kazukiminemura/block_illumination/docs/README.md

# 現行構成の概要

Pico 2 H ×1、XD3914 ×3、OSX10201-GYR1 ×3の3チャンネル構成です。

[概要図](overview.svg) → [実端子付き配線図](../hardware/schematic.svg) → [設計・組立・校正手順](../hardware/README.md) の順に参照してください。

Rev CはLTspiceの近似モデルで検証済み、実機検証は未実施です。

概要図再生成：`node docs/build-overview.cjs`。
