kazukiminemura/block_illumination/hardware/connections.csv

reference | physical_pin | function_or_value | net
PICO | 3 | GND | GND
J_PWR | 1 | external regulated 5V +/-5% | 5V
J_PWR | 2 | GND | GND
PICO | 1 | GP0 PWM 20kHz | PWM_CPU
RF_CPU | 1 | 4.7k 1% | PWM_CPU
RF_CPU | 2 | 4.7k 1% | SIG_CPU
RPD_CPU | 1 | 10k | PWM_CPU
RPD_CPU | 2 | 10k | GND
CF_CPU | 1 | 4.7uF X7R >=10V | SIG_CPU
CF_CPU | 2 | 4.7uF X7R >=10V | GND
U_CPU | 2 | GND | GND
U_CPU | 3 | V+ | 5V
U_CPU | 4 | RLO | GND
U_CPU | 5 | SIG | SIG_CPU
U_CPU | 6 | RHI | REF_CPU
U_CPU | 7 | REF_OUT | REF_CPU
U_CPU | 8 | REF_ADJ | GND
U_CPU | 9 | MODE_BAR | 5V
RSET_CPU | 1 | 3.3k 1% | REF_CPU
RSET_CPU | 2 | 3.3k 1% | GND
U_CPU | 1 | OUT1 | K_CPU_1
LED_CPU | 1 | A anode | 5V
LED_CPU | 20 | A cathode | K_CPU_1
U_CPU | 18 | OUT2 | K_CPU_2
LED_CPU | 2 | B anode | 5V
LED_CPU | 19 | B cathode | K_CPU_2
U_CPU | 17 | OUT3 | K_CPU_3
LED_CPU | 3 | C anode | 5V
LED_CPU | 18 | C cathode | K_CPU_3
U_CPU | 16 | OUT4 | K_CPU_4
LED_CPU | 4 | D anode | 5V
LED_CPU | 17 | D cathode | K_CPU_4
U_CPU | 15 | OUT5 | K_CPU_5
LED_CPU | 5 | E anode | 5V
LED_CPU | 16 | E cathode | K_CPU_5
U_CPU | 14 | OUT6 | K_CPU_6
LED_CPU | 6 | F anode | 5V
LED_CPU | 15 | F cathode | K_CPU_6
U_CPU | 13 | OUT7 | K_CPU_7
LED_CPU | 7 | G anode | 5V
LED_CPU | 14 | G cathode | K_CPU_7
U_CPU | 12 | OUT8 | K_CPU_8
LED_CPU | 8 | H anode | 5V
LED_CPU | 13 | H cathode | K_CPU_8
U_CPU | 11 | OUT9 | K_CPU_9
LED_CPU | 9 | I anode | 5V
LED_CPU | 12 | I cathode | K_CPU_9
U_CPU | 10 | OUT10 | K_CPU_10
LED_CPU | 10 | J anode | 5V
LED_CPU | 11 | J cathode | K_CPU_10
CD_CPU | 1 | 100nF X7R >=10V | 5V
CD_CPU | 2 | 100nF X7R >=10V | GND
CB_CPU | 1 | 10uF >=10V | 5V
CB_CPU | 2 | 10uF >=10V | GND
PICO | 4 | GP2 PWM 20kHz | PWM_GPU
RF_GPU | 1 | 4.7k 1% | PWM_GPU
RF_GPU | 2 | 4.7k 1% | SIG_GPU
RPD_GPU | 1 | 10k | PWM_GPU
RPD_GPU | 2 | 10k | GND
CF_GPU | 1 | 4.7uF X7R >=10V | SIG_GPU
CF_GPU | 2 | 4.7uF X7R >=10V | GND
U_GPU | 2 | GND | GND
U_GPU | 3 | V+ | 5V
U_GPU | 4 | RLO | GND
U_GPU | 5 | SIG | SIG_GPU
U_GPU | 6 | RHI | REF_GPU
U_GPU | 7 | REF_OUT | REF_GPU
U_GPU | 8 | REF_ADJ | GND
U_GPU | 9 | MODE_BAR | 5V
RSET_GPU | 1 | 3.3k 1% | REF_GPU
RSET_GPU | 2 | 3.3k 1% | GND
U_GPU | 1 | OUT1 | K_GPU_1
LED_GPU | 1 | A anode | 5V
LED_GPU | 20 | A cathode | K_GPU_1
U_GPU | 18 | OUT2 | K_GPU_2
LED_GPU | 2 | B anode | 5V
LED_GPU | 19 | B cathode | K_GPU_2
U_GPU | 17 | OUT3 | K_GPU_3
LED_GPU | 3 | C anode | 5V
LED_GPU | 18 | C cathode | K_GPU_3
U_GPU | 16 | OUT4 | K_GPU_4
LED_GPU | 4 | D anode | 5V
LED_GPU | 17 | D cathode | K_GPU_4
U_GPU | 15 | OUT5 | K_GPU_5
LED_GPU | 5 | E anode | 5V
LED_GPU | 16 | E cathode | K_GPU_5
U_GPU | 14 | OUT6 | K_GPU_6
LED_GPU | 6 | F anode | 5V
LED_GPU | 15 | F cathode | K_GPU_6
U_GPU | 13 | OUT7 | K_GPU_7
LED_GPU | 7 | G anode | 5V
LED_GPU | 14 | G cathode | K_GPU_7
U_GPU | 12 | OUT8 | K_GPU_8
LED_GPU | 8 | H anode | 5V
LED_GPU | 13 | H cathode | K_GPU_8
U_GPU | 11 | OUT9 | K_GPU_9
LED_GPU | 9 | I anode | 5V
LED_GPU | 12 | I cathode | K_GPU_9
U_GPU | 10 | OUT10 | K_GPU_10
LED_GPU | 10 | J anode | 5V
LED_GPU | 11 | J cathode | K_GPU_10
CD_GPU | 1 | 100nF X7R >=10V | 5V
CD_GPU | 2 | 100nF X7R >=10V | GND
CB_GPU | 1 | 10uF >=10V | 5V
CB_GPU | 2 | 10uF >=10V | GND
PICO | 6 | GP4 PWM 20kHz | PWM_NPU
RF_NPU | 1 | 4.7k 1% | PWM_NPU
RF_NPU | 2 | 4.7k 1% | SIG_NPU
RPD_NPU | 1 | 10k | PWM_NPU
RPD_NPU | 2 | 10k | GND
CF_NPU | 1 | 4.7uF X7R >=10V | SIG_NPU
CF_NPU | 2 | 4.7uF X7R >=10V | GND
U_NPU | 2 | GND | GND
U_NPU | 3 | V+ | 5V
U_NPU | 4 | RLO | GND
U_NPU | 5 | SIG | SIG_NPU
U_NPU | 6 | RHI | REF_NPU
U_NPU | 7 | REF_OUT | REF_NPU
U_NPU | 8 | REF_ADJ | GND
U_NPU | 9 | MODE_BAR | 5V
RSET_NPU | 1 | 3.3k 1% | REF_NPU
RSET_NPU | 2 | 3.3k 1% | GND
U_NPU | 1 | OUT1 | K_NPU_1
LED_NPU | 1 | A anode | 5V
LED_NPU | 20 | A cathode | K_NPU_1
U_NPU | 18 | OUT2 | K_NPU_2
LED_NPU | 2 | B anode | 5V
LED_NPU | 19 | B cathode | K_NPU_2
U_NPU | 17 | OUT3 | K_NPU_3
LED_NPU | 3 | C anode | 5V
LED_NPU | 18 | C cathode | K_NPU_3
U_NPU | 16 | OUT4 | K_NPU_4
LED_NPU | 4 | D anode | 5V
LED_NPU | 17 | D cathode | K_NPU_4
U_NPU | 15 | OUT5 | K_NPU_5
LED_NPU | 5 | E anode | 5V
LED_NPU | 16 | E cathode | K_NPU_5
U_NPU | 14 | OUT6 | K_NPU_6
LED_NPU | 6 | F anode | 5V
LED_NPU | 15 | F cathode | K_NPU_6
U_NPU | 13 | OUT7 | K_NPU_7
LED_NPU | 7 | G anode | 5V
LED_NPU | 14 | G cathode | K_NPU_7
U_NPU | 12 | OUT8 | K_NPU_8
LED_NPU | 8 | H anode | 5V
LED_NPU | 13 | H cathode | K_NPU_8
U_NPU | 11 | OUT9 | K_NPU_9
LED_NPU | 9 | I anode | 5V
LED_NPU | 12 | I cathode | K_NPU_9
U_NPU | 10 | OUT10 | K_NPU_10
LED_NPU | 10 | J anode | 5V
LED_NPU | 11 | J cathode | K_NPU_10
CD_NPU | 1 | 100nF X7R >=10V | 5V
CD_NPU | 2 | 100nF X7R >=10V | GND
CB_NPU | 1 | 10uF >=10V | 5V
CB_NPU | 2 | 10uF >=10V | GND
CBULK | 1 | 100uF >=10V | 5V
CBULK | 2 | 100uF >=10V | GND
