kazukiminemura/block_illumination/docs/overview.png

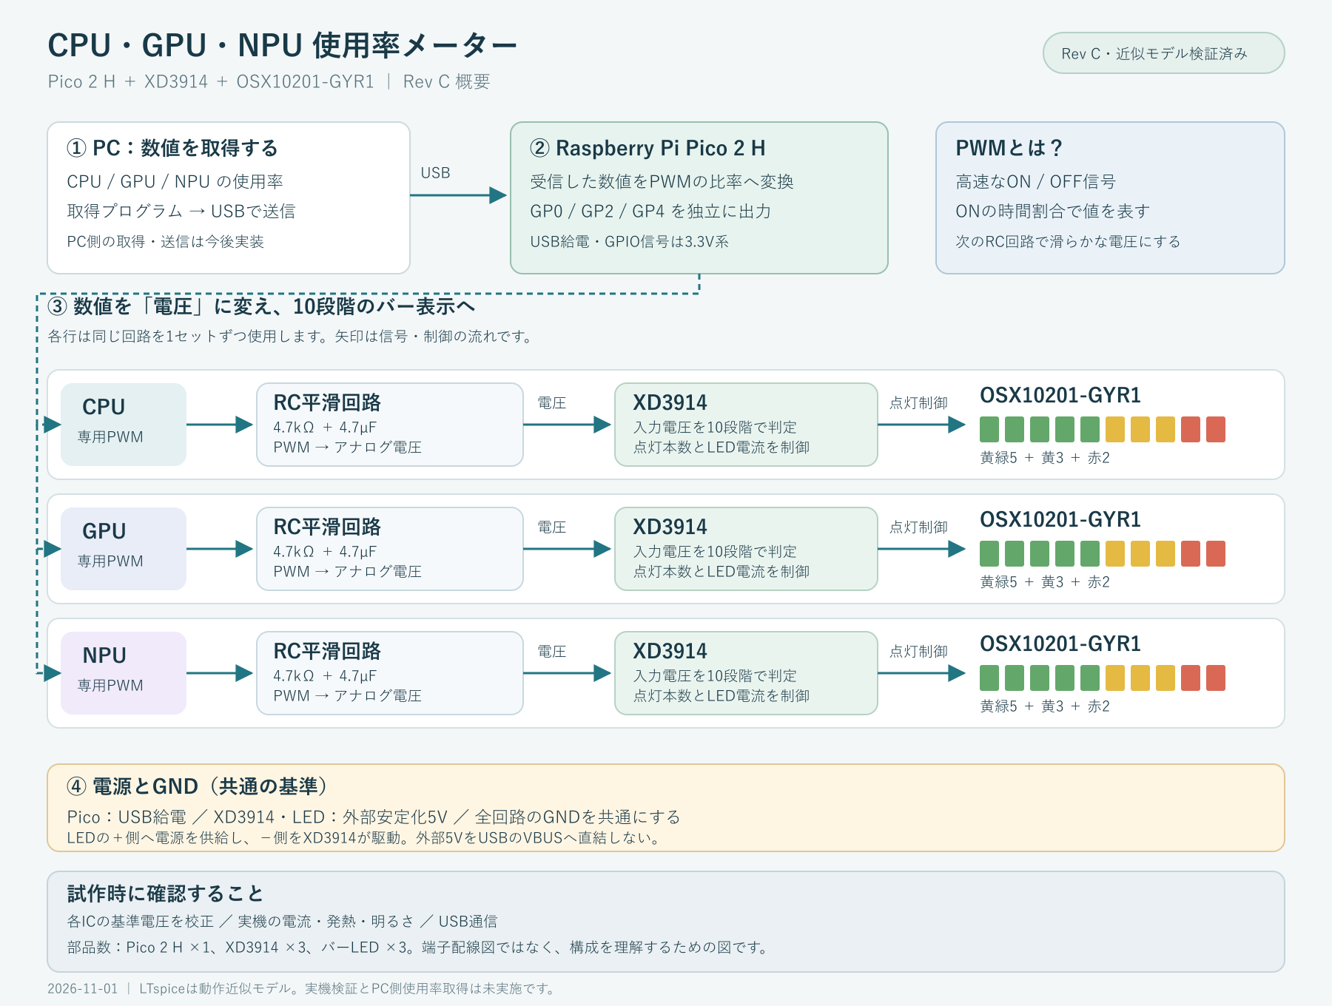
docs/overview.png
