kazukiminemura/block_illumination/hardware/schematic.png

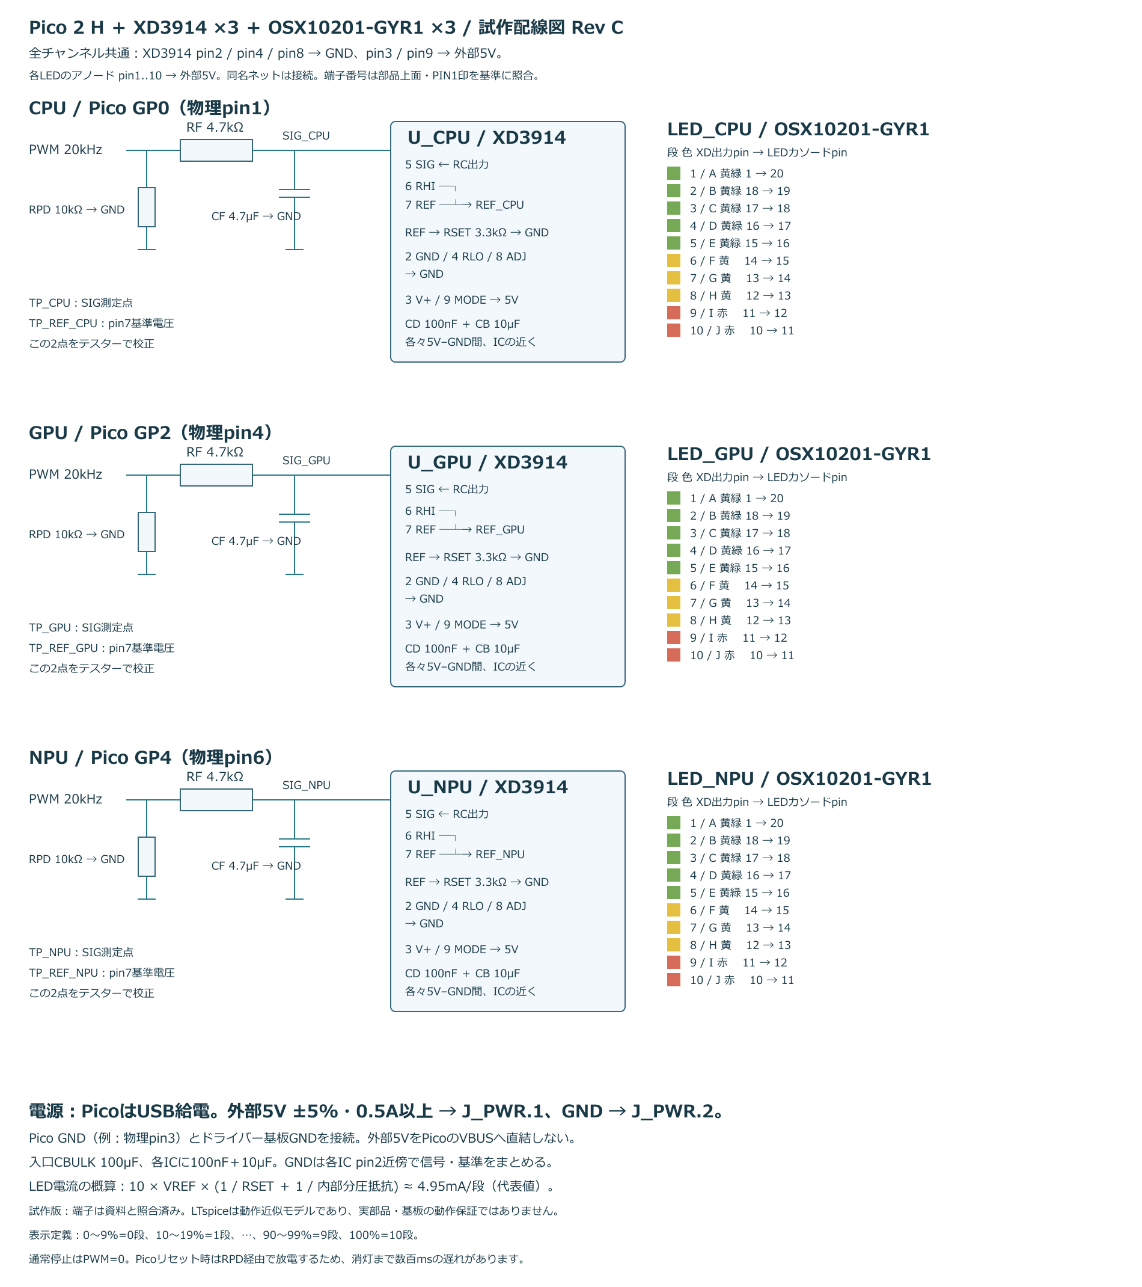
hardware/schematic.png
