kazukiminemura/block_illumination/simulation/ltspice/level_meter.asc

CB_CPU: cap; 10u Rser=0.1
CB_GPU: cap; 10u Rser=0.1
CB_NPU: cap; 10u Rser=0.1
CBULK: cap; 100u Rser=0.1
CD_CPU: cap; 100n
CD_GPU: cap; 100n
CD_NPU: cap; 100n
CF_CPU: cap; {CFVAL}
CF_GPU: cap; {CFVAL}
CF_NPU: cap; {CFVAL}
RF_CPU: res; {4700*RFAC}
RF_GPU: res; {4700*RFAC}
RF_NPU: res; {4700*RFAC}
RFEED: res; 0.1
RPD_CPU: res; 10k
RPD_GPU: res; 10k
RPD_NPU: res; 10k
RSET_CPU: res; {3300*RSETFAC}
RSET_GPU: res; {3300*RSETFAC}
RSET_NPU: res; {3300*RSETFAC}
SIO_CPU: sw; GPIO_SW
SIO_GPU: sw; GPIO_SW
SIO_NPU: sw; GPIO_SW
VDD: voltage; 5
VEN: voltage; PWL(0 1 399.999m 1 400m 0)
VLOGIC_CPU: voltage; 0
VLOGIC_GPU: voltage; 0
VLOGIC_NPU: voltage; 0
VPWM_CPU: voltage; PULSE(0 {VGPIO} 100m 20n 20n {DT0*50u} 50u)
VPWM_GPU: voltage; PULSE(0 {VGPIO} 100m 20n 20n {DT1*50u} 50u)
VPWM_NPU: voltage; PULSE(0 {VGPIO} 100m 20n 20n {DT2*50u} 50u)
VS_CPU_1: voltage; 0
VS_CPU_2: voltage; 0
VS_CPU_3: voltage; 0
VS_CPU_4: voltage; 0
VS_CPU_5: voltage; 0
VS_CPU_6: voltage; 0
VS_CPU_7: voltage; 0
VS_CPU_8: voltage; 0
VS_CPU_9: voltage; 0
VS_CPU_10: voltage; 0
VS_GPU_1: voltage; 0
VS_GPU_2: voltage; 0
VS_GPU_3: voltage; 0
VS_GPU_4: voltage; 0
VS_GPU_5: voltage; 0
VS_GPU_6: voltage; 0
VS_GPU_7: voltage; 0
VS_GPU_8: voltage; 0
VS_GPU_9: voltage; 0
VS_GPU_10: voltage; 0
VS_NPU_1: voltage; 0
VS_NPU_2: voltage; 0
VS_NPU_3: voltage; 0
VS_NPU_4: voltage; 0
VS_NPU_5: voltage; 0
VS_NPU_6: voltage; 0
VS_NPU_7: voltage; 0
VS_NPU_8: voltage; 0
VS_NPU_9: voltage; 0
VS_NPU_10: voltage; 0
XLED_CPU: OSX10201_GYR1
XLED_GPU: OSX10201_GYR1
XLED_NPU: OSX10201_GYR1
XU_CPU: XD3914; XD3914 VREFVAL={VR0} RLAD={RLADVAL} ERR={THERR} ISCALE={ISCALE}
XU_GPU: XD3914; XD3914 VREFVAL={VR1} RLAD={RLADVAL} ERR={THERR} ISCALE={ISCALE}
XU_NPU: XD3914; XD3914 VREFVAL={VR2} RLAD={RLADVAL} ERR={THERR} ISCALE={ISCALE}
Named nets: VIN, 0, 5V, DRIVE_CPU, PWM_CPU, EN, SIG_CPU, K_CPU_1_SINK, VCC_CPU, REF_CPU, K_CPU_10_SINK, K_CPU_9_SINK, K_CPU_8_SINK, K_CPU_7_SINK, K_CPU_6_SINK, K_CPU_5_SINK, K_CPU_4_SINK, K_CPU_3_SINK, K_CPU_2_SINK, K_CPU_10, K_CPU_9, K_CPU_8, K_CPU_7, K_CPU_6, K_CPU_5, K_CPU_4, K_CPU_3, K_CPU_2, K_CPU_1, DRIVE_GPU, PWM_GPU, SIG_GPU, K_GPU_1_SINK, VCC_GPU, REF_GPU, K_GPU_10_SINK, K_GPU_9_SINK, K_GPU_8_SINK, K_GPU_7_SINK, K_GPU_6_SINK, K_GPU_5_SINK, K_GPU_4_SINK, K_GPU_3_SINK, K_GPU_2_SINK, K_GPU_10, K_GPU_9, K_GPU_8, K_GPU_7, K_GPU_6, K_GPU_5, K_GPU_4, K_GPU_3, K_GPU_2, K_GPU_1, DRIVE_NPU, PWM_NPU, SIG_NPU, K_NPU_1_SINK, VCC_NPU, REF_NPU, K_NPU_10_SINK, K_NPU_9_SINK, K_NPU_8_SINK, K_NPU_7_SINK, K_NPU_6_SINK, K_NPU_5_SINK, K_NPU_4_SINK, K_NPU_3_SINK, K_NPU_2_SINK, K_NPU_10, K_NPU_9, K_NPU_8, K_NPU_7, K_NPU_6, K_NPU_5, K_NPU_4, K_NPU_3, K_NPU_2, K_NPU_1
Pico 2 H / XD3914 x3 / OSX10201-GYR1 x3 - PWM / RESET TEST
Same net labels connect. VS_* and VLOGIC_* are zero-volt measurement sources, not hardware parts.
Behavioral IC and LED models. Bar mode only. Physical pin IDs on custom symbols.
.include meter_models.lib
.param VR0=1.28 VR1=1.28 VR2=1.28 VGPIO=3.3 RFAC=1 CFVAL=4.7u RSETFAC=1 RLADVAL=12k THERR=0 ISCALE=1
.param DT0={(3.5/10)*VR0/VGPIO} DT1={(6.5/10)*VR1/VGPIO} DT2={1.08*VR2/VGPIO}
.options plotwinsize=0
.save V(5V) V(EN) V(SIG_CPU) V(REF_CPU) V(VCC_CPU) I(VLOGIC_CPU) V(SIG_GPU) V(REF_GPU) V(VCC_GPU) I(VLOGIC_GPU) V(SIG_NPU) V(REF_NPU) V(VCC_NPU) I(VLOGIC_NPU) I(VS_CPU_1) V(K_CPU_1_SINK) I(VS_CPU_2) V(K_CPU_2_SINK) I(VS_CPU_3) V(K_CPU_3_SINK) I(VS_CPU_4) V(K_CPU_4_SINK) I(VS_CPU_5) V(K_CPU_5_SINK) I(VS_CPU_6) V(K_CPU_6_SINK) I(VS_CPU_7) V(K_CPU_7_SINK) I(VS_CPU_8) V(K_CPU_8_SINK) I(VS_CPU_9) V(K_CPU_9_SINK) I(VS_CPU_10) V(K_CPU_10_SINK) I(VS_GPU_1) V(K_GPU_1_SINK) I(VS_GPU_2) V(K_GPU_2_SINK) I(VS_GPU_3) V(K_GPU_3_SINK) I(VS_GPU_4) V(K_GPU_4_SINK) I(VS_GPU_5) V(K_GPU_5_SINK) I(VS_GPU_6) V(K_GPU_6_SINK) I(VS_GPU_7) V(K_GPU_7_SINK) I(VS_GPU_8) V(K_GPU_8_SINK) I(VS_GPU_9) V(K_GPU_9_SINK) I(VS_GPU_10) V(K_GPU_10_SINK) I(VS_NPU_1) V(K_NPU_1_SINK) I(VS_NPU_2) V(K_NPU_2_SINK) I(VS_NPU_3) V(K_NPU_3_SINK) I(VS_NPU_4) V(K_NPU_4_SINK) I(VS_NPU_5) V(K_NPU_5_SINK) I(VS_NPU_6) V(K_NPU_6_SINK) I(VS_NPU_7) V(K_NPU_7_SINK) I(VS_NPU_8) V(K_NPU_8_SINK) I(VS_NPU_9) V(K_NPU_9_SINK) I(VS_NPU_10) V(K_NPU_10_SINK) I(VDD)
.step param CFVAL list 2.2u 6.8u
.tran 0 800m 0 2u
.meas tran CPU_SIG AVG V(SIG_CPU) FROM 330m TO 350m
.meas tran CPU_RIPPLE PP V(SIG_CPU) FROM 330m TO 350m
.meas tran CPU_COUNT FIND (if(I(VS_CPU_1)>1m,1,0)+if(I(VS_CPU_2)>1m,1,0)+if(I(VS_CPU_3)>1m,1,0)+if(I(VS_CPU_4)>1m,1,0)+if(I(VS_CPU_5)>1m,1,0)+if(I(VS_CPU_6)>1m,1,0)+if(I(VS_CPU_7)>1m,1,0)+if(I(VS_CPU_8)>1m,1,0)+if(I(VS_CPU_9)>1m,1,0)+if(I(VS_CPU_10)>1m,1,0)) AT=350m
.meas tran CPU_RESET FIND (if(I(VS_CPU_1)>1m,1,0)+if(I(VS_CPU_2)>1m,1,0)+if(I(VS_CPU_3)>1m,1,0)+if(I(VS_CPU_4)>1m,1,0)+if(I(VS_CPU_5)>1m,1,0)+if(I(VS_CPU_6)>1m,1,0)+if(I(VS_CPU_7)>1m,1,0)+if(I(VS_CPU_8)>1m,1,0)+if(I(VS_CPU_9)>1m,1,0)+if(I(VS_CPU_10)>1m,1,0)) AT=750m
.meas tran CPU_I AVG I(VS_CPU_1) FROM 330m TO 350m
.meas tran CPU_P AVG (V(K_CPU_1_SINK)*I(VS_CPU_1)+V(K_CPU_2_SINK)*I(VS_CPU_2)+V(K_CPU_3_SINK)*I(VS_CPU_3)+V(K_CPU_4_SINK)*I(VS_CPU_4)+V(K_CPU_5_SINK)*I(VS_CPU_5)+V(K_CPU_6_SINK)*I(VS_CPU_6)+V(K_CPU_7_SINK)*I(VS_CPU_7)+V(K_CPU_8_SINK)*I(VS_CPU_8)+V(K_CPU_9_SINK)*I(VS_CPU_9)+V(K_CPU_10_SINK)*I(VS_CPU_10)+V(VCC_CPU)*I(VLOGIC_CPU)) FROM 330m TO 350m
.meas tran CPU_START FIND (if(I(VS_CPU_1)>1m,1,0)+if(I(VS_CPU_2)>1m,1,0)+if(I(VS_CPU_3)>1m,1,0)+if(I(VS_CPU_4)>1m,1,0)+if(I(VS_CPU_5)>1m,1,0)+if(I(VS_CPU_6)>1m,1,0)+if(I(VS_CPU_7)>1m,1,0)+if(I(VS_CPU_8)>1m,1,0)+if(I(VS_CPU_9)>1m,1,0)+if(I(VS_CPU_10)>1m,1,0)) AT=50m
.meas tran GPU_SIG AVG V(SIG_GPU) FROM 330m TO 350m
.meas tran GPU_RIPPLE PP V(SIG_GPU) FROM 330m TO 350m
.meas tran GPU_COUNT FIND (if(I(VS_GPU_1)>1m,1,0)+if(I(VS_GPU_2)>1m,1,0)+if(I(VS_GPU_3)>1m,1,0)+if(I(VS_GPU_4)>1m,1,0)+if(I(VS_GPU_5)>1m,1,0)+if(I(VS_GPU_6)>1m,1,0)+if(I(VS_GPU_7)>1m,1,0)+if(I(VS_GPU_8)>1m,1,0)+if(I(VS_GPU_9)>1m,1,0)+if(I(VS_GPU_10)>1m,1,0)) AT=350m
.meas tran GPU_RESET FIND (if(I(VS_GPU_1)>1m,1,0)+if(I(VS_GPU_2)>1m,1,0)+if(I(VS_GPU_3)>1m,1,0)+if(I(VS_GPU_4)>1m,1,0)+if(I(VS_GPU_5)>1m,1,0)+if(I(VS_GPU_6)>1m,1,0)+if(I(VS_GPU_7)>1m,1,0)+if(I(VS_GPU_8)>1m,1,0)+if(I(VS_GPU_9)>1m,1,0)+if(I(VS_GPU_10)>1m,1,0)) AT=750m
.meas tran GPU_I AVG I(VS_GPU_1) FROM 330m TO 350m
.meas tran GPU_P AVG (V(K_GPU_1_SINK)*I(VS_GPU_1)+V(K_GPU_2_SINK)*I(VS_GPU_2)+V(K_GPU_3_SINK)*I(VS_GPU_3)+V(K_GPU_4_SINK)*I(VS_GPU_4)+V(K_GPU_5_SINK)*I(VS_GPU_5)+V(K_GPU_6_SINK)*I(VS_GPU_6)+V(K_GPU_7_SINK)*I(VS_GPU_7)+V(K_GPU_8_SINK)*I(VS_GPU_8)+V(K_GPU_9_SINK)*I(VS_GPU_9)+V(K_GPU_10_SINK)*I(VS_GPU_10)+V(VCC_GPU)*I(VLOGIC_GPU)) FROM 330m TO 350m
.meas tran GPU_START FIND (if(I(VS_GPU_1)>1m,1,0)+if(I(VS_GPU_2)>1m,1,0)+if(I(VS_GPU_3)>1m,1,0)+if(I(VS_GPU_4)>1m,1,0)+if(I(VS_GPU_5)>1m,1,0)+if(I(VS_GPU_6)>1m,1,0)+if(I(VS_GPU_7)>1m,1,0)+if(I(VS_GPU_8)>1m,1,0)+if(I(VS_GPU_9)>1m,1,0)+if(I(VS_GPU_10)>1m,1,0)) AT=50m
.meas tran NPU_SIG AVG V(SIG_NPU) FROM 330m TO 350m
.meas tran NPU_RIPPLE PP V(SIG_NPU) FROM 330m TO 350m
.meas tran NPU_COUNT FIND (if(I(VS_NPU_1)>1m,1,0)+if(I(VS_NPU_2)>1m,1,0)+if(I(VS_NPU_3)>1m,1,0)+if(I(VS_NPU_4)>1m,1,0)+if(I(VS_NPU_5)>1m,1,0)+if(I(VS_NPU_6)>1m,1,0)+if(I(VS_NPU_7)>1m,1,0)+if(I(VS_NPU_8)>1m,1,0)+if(I(VS_NPU_9)>1m,1,0)+if(I(VS_NPU_10)>1m,1,0)) AT=350m
.meas tran NPU_RESET FIND (if(I(VS_NPU_1)>1m,1,0)+if(I(VS_NPU_2)>1m,1,0)+if(I(VS_NPU_3)>1m,1,0)+if(I(VS_NPU_4)>1m,1,0)+if(I(VS_NPU_5)>1m,1,0)+if(I(VS_NPU_6)>1m,1,0)+if(I(VS_NPU_7)>1m,1,0)+if(I(VS_NPU_8)>1m,1,0)+if(I(VS_NPU_9)>1m,1,0)+if(I(VS_NPU_10)>1m,1,0)) AT=750m
.meas tran NPU_I AVG I(VS_NPU_1) FROM 330m TO 350m
.meas tran NPU_P AVG (V(K_NPU_1_SINK)*I(VS_NPU_1)+V(K_NPU_2_SINK)*I(VS_NPU_2)+V(K_NPU_3_SINK)*I(VS_NPU_3)+V(K_NPU_4_SINK)*I(VS_NPU_4)+V(K_NPU_5_SINK)*I(VS_NPU_5)+V(K_NPU_6_SINK)*I(VS_NPU_6)+V(K_NPU_7_SINK)*I(VS_NPU_7)+V(K_NPU_8_SINK)*I(VS_NPU_8)+V(K_NPU_9_SINK)*I(VS_NPU_9)+V(K_NPU_10_SINK)*I(VS_NPU_10)+V(VCC_NPU)*I(VLOGIC_NPU)) FROM 330m TO 350m
.meas tran NPU_START FIND (if(I(VS_NPU_1)>1m,1,0)+if(I(VS_NPU_2)>1m,1,0)+if(I(VS_NPU_3)>1m,1,0)+if(I(VS_NPU_4)>1m,1,0)+if(I(VS_NPU_5)>1m,1,0)+if(I(VS_NPU_6)>1m,1,0)+if(I(VS_NPU_7)>1m,1,0)+if(I(VS_NPU_8)>1m,1,0)+if(I(VS_NPU_9)>1m,1,0)+if(I(VS_NPU_10)>1m,1,0)) AT=50m
.meas tran SUPPLY_MIN MIN V(5V) FROM 0 TO 800m
