kazukiminemura/block_illumination/(commit log)

2026-10-31 feat: LTspice回路図とLED走査検証を追加
    LED表示器の接続と行切替を再現可能にし、消灯待ち時間を検証するため。
    [connections.csv, results.csv]
2026-10-31 feat: LED表示器の全体回路図と検証を追加
    全16行とLED3枚の接続・走査をLTspiceで確認可能にするため。
2026-11-01 feat: Rev B試作回路図と検証資料を追加
    実端子配線と初期消灯回路を具体化し、試作条件を再現可能にするため。
    [assembly-connections.csv, bom.csv, connections.csv, results.csv]
2026-11-01 fix: 旧版回路図とプレビューの生成処理を削除
    Rev Bへの更新後に旧版図面が残り、再生成されることを防ぐため。
2026-11-01 feat: XD3914使用率メーターへ再設計
    指定部品に合わせて回路と検証を作り直し、旧設計との混同を防ぐため。
    [assembly-connections.csv, bom.csv, connections.csv, results.csv]
2026-11-01 feat: 回路全体の3D分解ビューを追加
    部品配置と端子接続を立体表示で確認できるようにするため。
2026-11-01 fix: 検証証跡と3D接続データの誤判定を防止
    古い測定ログや欠落した接続データが合格扱いされ、証跡が上書きされるのを防ぐため。
